teo1747/stm32-freertos-access-control/(commit log)

2026-10-28 Vendor the FreeRTOS kernel V11.3.1, CMSIS core and ST's STM32F446 header
    Only the files the firmware builds: the kernel, its ARM_CM4F port and
    heap_4, CMSIS's Cortex-M4 headers, ST's device header. Each keeps its
    license.
2026-10-28 Add the platform layer: startup, linker script, clocks, fault record
    The vector table from ST's interrupt list, the clock tree at 180 MHz from
    the ST-LINK's 8 MHz (HSI fallback), FreeRTOS's configuration, the reset
    cause, and a fault record kept in .noinit across the reset that follows a
    hard fault, an assertion, a stack overflow or an allocation failure.
    [board.h, fault.c, fault.h, startup.c, system.c, system.h]
2026-10-28 Add register-level drivers: GPIO, UART, I2C, SPI, PWM, watchdog
    UART on interrupts with FreeRTOS stream buffers; I2C master on its event
    and error interrupts after RM0390's sequences, with bus recovery; polled
    SPI for the MFRC522; TIM2 and TIM3 PWM for the servo and the buzzer; the
    independent watchdog.
    [gpio.c, gpio.h, i2c.c, i2c.h, iwdg.c, iwdg.h, pwm.c, pwm.h]
2026-10-28 Add device drivers: DS3231, 24LC256, SSD1306, MFRC522, keypad
2026-10-28 Add the EmbSIM circuit, scenarios and the OLED screenshot tool
2026-10-28 Fix two I2C master races found in simulation
    A one-byte read wrote CR1 (the NACK) between the SR1 and SR2 reads that
    clear ADDR. Some implementations take that as breaking the sequence and
    keep ADDR set, so the event interrupt re-entered forever. SR1 is now
    read again just before SR2, as ST's HAL does.
    After the write part of a register read, BTF stays set until the
    repeated START goes out, so the interrupt re-entered at once. Already in
    the read phase, with two bytes to read, it set STOP and read DR twice: the
    DS3231's temperature came back as its register address. A restarting
    phase now waits for SB.
    [i2c.c]
2026-10-28 Add the clock and display scenario
    The I2C bus scan finds the OLED, the EEPROM and the RTC; the time set
    from the shell reads back with the DS3231's temperature; the OLED is on
    and shows the idle clock.
2026-10-28 Add the access rules, the user database and the access log
    The rules are a state machine fed with events (card, key, door contact,
    exit button, time, admin requests) that reaches hardware, storage and the
    screen only through callbacks: card alone or card and PIN, hours of
    access, lockout doubling with each round of wrong PINs, forced-door and
    held-open alarms, egress always allowed, card enrolment.
    Users are 64-byte records, one EEPROM page each, with a CRC; PINs are
    salted SHA-256 hashes stretched over 1024 rounds and compared in constant
    time. The access log is a ring of 256 records whose sequence numbers make
    a head pointer unnecessary; torn records fail their CRC and are skipped.
    Unit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
    [mfrc522.c, mfrc522.h]
2026-10-28 Fix I2C transfers woken by another task notification
    The I2C driver slept on the calling task's notification at index 0, which
    the display task also uses to be told to redraw. A redraw request pending
    when the display task started its first transfer ended that transfer at
    once, reported as a timeout. Drivers now use their own notification index,
    and a transfer clears it before starting.
    The driver also keeps what the last failed transfer was doing (address,
    phase, bytes left, status registers) for the shell's i2c command.
    [i2c.c, i2c.h]
2026-10-28 Wire the terminal together: tasks, storage, door, inputs, admin shell
    The terminal task owns the access rules and takes every event through
    its queue. The reader task reports a card once on arrival; the inputs task
    debounces the keypad, the exit button and the door contact. Storage puts
    the user database and the log on the EEPROM under one lock. The door
    module drives the servo, the LEDs and the buzzer's tunes. The supervisor
    brings the devices up in order and feeds the watchdog only while every
    task checks in, naming a stalled task in the fault record.
    The admin shell gains a login (salted PIN, lockout after failures, idle
    logout) and the commands to manage users, read and clear the log, o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
    [admin.c, door.c, door.h, inputs.c, inputs.h, storage.c, storage.h, supervisor.c]
2026-10-28 Add the access scenarios and a scenario runner
    access-flow: an unknown card denied, enrolment by presenting the card,
    card and PIN, the door opening and relocking. alarms: a forced door, a
    non-admin refused, an admin clearing it, the exit button during the
    alarm. lockout: three wrong PINs, cards ignored, the right PIN after.
    The pull-ups are EmbSIM pull_up parts: the same resistance, kept out of
    the board's power network, which makes the runs eight times faster.
    tools/simtest.py runs every scenario in parallel and summarises.
    [oled_png.py, simtest.py]
2026-10-28 Document the terminal: screens, wiring, parts, testing
    The README's pictures come from the simulation: the OLED's frames from
    EmbSIM runs of the scenarios, drawn by tools/oled_png.py, and a wiring
    diagram generated from the pin map by tools/wiring_svg.py.
    docs/hardware.md lists the parts and the wiring.
2026-10-28 Cite RM0390's I2C chapter without a section number
